earth-repo/iceBox/รูป2/IMG_0160.jpg

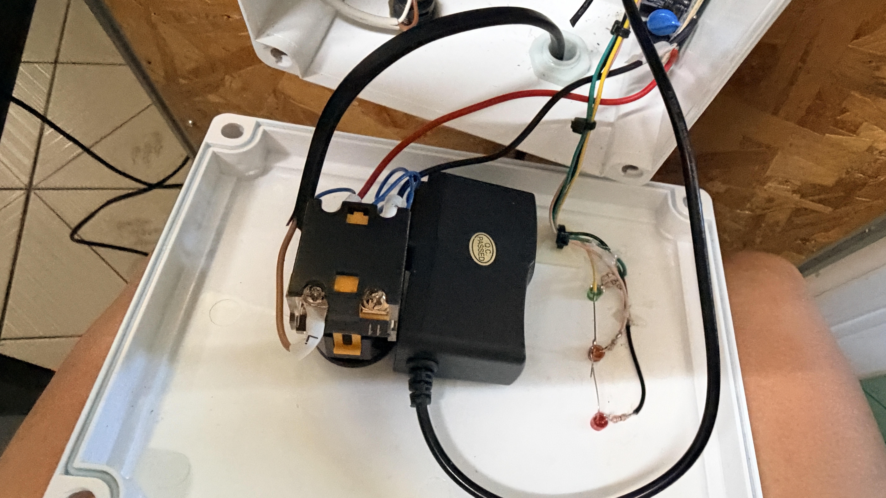
รูป2/IMG_0160.jpg
