earth-repo/iceBox/รูป2/IMG_0157.jpg

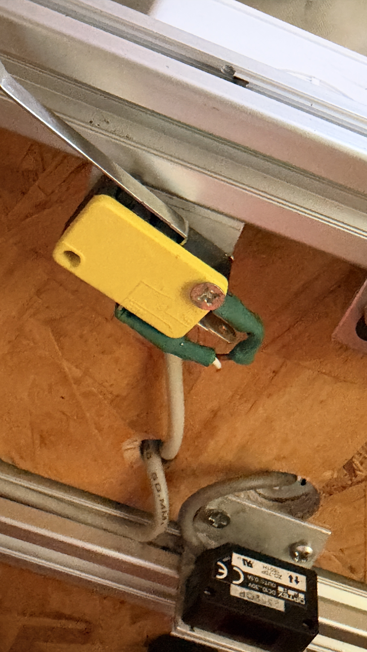
รูป2/IMG_0157.jpg
