earth-repo/iceBox/RESEARCH_REFERENCES.docx

# Research References

Telegram Notification and Internet of Things (IoT)

Peer-reviewed journal articles and conference papers supporting the Smart Parcel Receiving Box project

# 1. Telegram Bot as an IoT Notification Channel

Research papers that use the Telegram Bot API as the mobile alerting channel for an IoT system — the same architecture adopted in this project.

[1] M. N. Osman, M. H. F. Ismail, K. A. Sedek, N. A. Othman, and M. Maghribi, “A Low-Cost Home Security Notification System Using IoT and Telegram Bot: A Design and Implementation,” Journal of Computing Research and Innovation (JCRINN), vol. 7, no. 2, pp. 327–337, 2022. DOI: 10.24191/jcrinn.v7i2.325

https://doi.org/10.24191/jcrinn.v7i2.325

https://jcrinn.com/index.php/jcrinn/article/view/325

Motion sensors and a camera send alert messages containing photo, timestamp and location through a Telegram bot to the homeowner. Reports that the system was efficient, effective, low-cost and easy to use, with positive user-acceptance testing. Use as the principal citation that Telegram bots are an established, validated low-cost notification channel for IoT security applications.

[2] M. I. M. Abu Zaid, R. Abdullah, S. I. Ismail, and N. N. S. N. Dzulkefli, “IoT-based Emergency Alert System Integrated with Telegram Bot,” in Proc. 2023 IEEE International Conference on Automatic Control and Intelligent Systems (I2CACIS), 2023, pp. 126–131. DOI: 10.1109/I2CACIS57635.2023.10193550

https://doi.org/10.1109/i2cacis57635.2023.10193550

https://ieeexplore.ieee.org/document/10193550/

IEEE-indexed conference paper integrating a Telegram bot to extend the notification capability of an IoT alert system. The strongest IEEE citation available specifically for the Telegram-as-alert-channel design decision.

[3] D. N. Bestari and A. Wibowo, “An IoT Based Real-Time Weather Monitoring System Using Telegram Bot and Thingsboard Platform,” International Journal of Interactive Mobile Technologies (iJIM), vol. 17, no. 6, pp. 4–19, 2023. DOI: 10.3991/ijim.v17i06.34129

https://doi.org/10.3991/ijim.v17i06.34129

https://online-journals.org/index.php/i-jim/article/view/34129

Highly relevant to the notification-throttling design: reports Telegram notifications delivered within 3–5 seconds of a critical condition, while normal-condition messages are delayed by 10 minutes explicitly to avoid message spamming. This is the peer-reviewed justification for the cooldown timer (TELEGRAM_COOLDOWN_MS) and the sustained-trigger delay (MAX_SENSOR_DELAY_MS) used in this project. It also pairs a bot with a dashboard platform, mirroring the Telegram + Firebase dashboard split here.

[4] EJASET, “Development of an Internet-of-Things (IoT) Based Security System Using ESP32 MCU and the Telegram Bot,” European Journal of Applied Science, Engineering and Technology.

https://ejaset.com/index.php/journal/article/view/524

Closest match to this project's exact hardware/software stack — ESP32 microcontroller as the sensing node with the Telegram Bot as the notification medium. Primary related-work citation for the controller-plus-Telegram combination.

[5] Y. Yulianto et al., “Rancang Bangun Smart Home berbasis IoT Menggunakan Telegram Messenger Bot dan NodeMCU ESP32,” TELKA — Telekomunikasi, Elektronika, Komputasi dan Kontrol, vol. 9, no. 1, pp. 34–43, 2023.

https://telka.ee.uinsgd.ac.id/index.php/TELKA/article/view/telka.v9n1.34-43

Peer-reviewed smart-home implementation pairing a Telegram Messenger bot with an ESP32 for both monitoring and two-way control. Useful for arguing the future-work extension from one-way notification to bidirectional command (e.g. remotely resetting the parcel count).

[6] P. Kumar et al., “Development of an IoT-based Intelligent Energy Management System with Motion Notification on Telegram in a Smart Home,” in Proc. 5th International Conference on Information Management & Machine Intelligence (ICIMMI), ACM, 2023. DOI: 10.1145/3647444.3647921

https://dl.acm.org/doi/10.1145/3647444.3647921

ACM-indexed paper using a Telegram chatbot for real-time status notification so that the occupant stays informed while away from the premises — exactly the use case of the parcel box (owner is away when the parcel arrives).

# 2. Foundational IoT Research (Architecture & Technologies)

Highly cited survey papers used to define IoT and to frame the system-architecture chapter of the report.

[7] L. Atzori, A. Iera, and G. Morabito, “The Internet of Things: A survey,” Computer Networks, vol. 54, no. 15, pp. 2787–2805, Oct. 2010. DOI: 10.1016/j.comnet.2010.05.010

https://doi.org/10.1016/j.comnet.2010.05.010

https://www.cs.mun.ca/courses/cs6910/IoT-Survey-Atzori-2010.pdf

The seminal IoT survey (14,000+ citations). Establishes the three visions of IoT — things-oriented, internet-oriented and semantic-oriented — and the enabling technologies. The standard opening citation for any IoT literature review.

[8] A. Al-Fuqaha, M. Guizani, M. Mohammadi, M. Aledhari, and M. Ayyash, “Internet of Things: A Survey on Enabling Technologies, Protocols, and Applications,” IEEE Communications Surveys & Tutorials, vol. 17, no. 4, pp. 2347–2376, 2015. DOI: 10.1109/COMST.2015.2444095

https://doi.org/10.1109/COMST.2015.2444095

https://ieeexplore.ieee.org/document/7123563/

The most cited IEEE IoT survey. Defines the layered IoT model — the objects/perception layer (physical sensors that collect and process information), network, service and application layers — and compares application-layer protocols (HTTP, MQTT, CoAP, AMQP). Cite this to position the photoelectric sensor and ESP32 as the perception layer and to justify the choice of HTTP/REST as the application-layer protocol.

# 3. Research on Smart Parcel Boxes and Delivery Lockers

Directly comparable systems — the related-work core of the report.

[9] S. Panyoyai et al., “Development of A Smart Box Prototype for Mail and Parcel Posts Using IoT and Solar Energy,” in Proc. 2022 5th International Conference on Information and Communications Technology (ICOIACT), Yogyakarta, Indonesia, 2022, pp. 77–81. DOI: 10.1109/ICOIACT55506.2022.9972195

https://doi.org/10.1109/ICOIACT55506.2022.9972195

https://ieeexplore.ieee.org/document/9972195/

The closest IEEE-indexed precedent to this project. A smart box receives postal parcels and pushes an arrival notification to the recipient's phone (via LINE Notify), achieving an average performance of 96% across various envelope and parcel types. Use as the quantitative comparison baseline and to justify choosing Telegram over LINE Notify.

[10] M. R. Firdaus et al., “IoT-Based Package Drop Box System Using Arduino Uno and ESP32-CAM,” Jurnal Sistem Cerdas.

https://apic.id/jurnal/index.php/jsc/article/view/581

ESP32 + Telegram package drop box detecting parcel arrival with an ultrasonic sensor at ~10 cm, plus an ESP32-CAM for security. The key comparison point for the detection method: ultrasonic ranging versus the photoelectric beam-break counting used in this project — supports the argument that beam-break gives a discrete count per parcel, which ranging cannot.

[11] A. Rahman et al., “IoT-Based Smart Locker: Innovation in Automatic Package Reception,” TELKA — Telekomunikasi, Elektronika, Komputasi dan Kontrol, vol. 12, no. 1, pp. 17–22.

https://telka.ee.uinsgd.ac.id/TELKA/article/download/telka.v12n1.17-22/telka.v12n1.17-22_pdf/3075

Peer-reviewed automatic package-reception locker. Useful for comparing the mechanical reception workflow — particularly the separate deposit and retrieval access model, which matches the Input (top) / Output (front-bottom) door arrangement of this box.

[12] Design and implementation of an IoT-based automatic package box security system with vibration sensors and GSM notifications using ESP32, “Jurnal Sains, Teknologi & Komputer,”

https://jurnal.larisma.or.id/index.php/SAINTEK/article/view/1630

ESP32 parcel box with vibration-based anti-theft detection and GSM call notification. Comparison point for notification transport — GSM/SMS (recurring SIM cost, works without Wi-Fi) versus Wi-Fi/Internet messaging (zero marginal cost, requires coverage) — and a reference for anti-theft future work.

[13] T. Alsboui et al., “Design and Implementation of an IoT-Integrated Smart Locker System utilizing Facial Recognition Technology,” Engineering, Technology & Applied Science Research (ETASR), vol. 14, no. 4, Aug. 2024.

https://etasr.com/index.php/ETASR/article/view/7737

Recent Scopus-indexed smart-locker research using ESP32 and Firebase with a dual-door design granting independent access to the courier and the owner. Directly supports both the two-door architecture and the Firebase backend choice, and points to authentication as future work.

[14] A Review Paper on Secure Smart Parcel Receiving System, “International Journal of Progressive Research in Engineering Management and Science (IJPREMS),”

https://www.ijprems.com/ijprems-paper/a-review-paper-on-secure-smart-parcel-receiving-system

Review article surveying secure smart parcel receiving systems. Useful for the problem-statement section — growth of e-commerce, parcel theft, and failed deliveries when the recipient is absent.

# 4. Research on Telegram Platform Security and Reliability

Papers supporting the security-analysis and limitations chapter.

[15] M. Miculan and N. Vitacolonna, “Automated Symbolic Verification of Telegram's MTProto 2.0,” arXiv:2012.03141, 2020.

https://arxiv.org/abs/2012.03141

Formal symbolic verification of MTProto 2.0, the cryptographic protocol suite underlying Telegram. Provides an academically rigorous statement of the security properties (and their boundaries) of the messaging platform the notification layer depends on.

[16] A. Edu, X. Ferrer-Aran, J. Such, and G. Suarez-Tangil, “Exploring the Security and Privacy Risks of Chatbots in Messaging Services,” in Proc. ACM Internet Measurement Conference (IMC), 2022.

https://strathprints.strath.ac.uk/85489/1/Edu_etal_ACM_IMC_2022_Exploring_the_security_and_privacy_risks_of_chatbots.pdf

ACM IMC measurement study of chatbot security and privacy risks across Discord, Telegram and WhatsApp, showing how bots can expose users' sensitive data. Cite as the balanced counter-argument in the limitations section: convenience and zero cost of a Telegram bot come with a third-party-platform trust assumption.

[17] A Large-Scale Study of Telegram Bots, “arXiv preprint,”

https://arxiv.org/abs/2603.24302

Large-scale empirical measurement of the Telegram bot ecosystem (32,000+ bots), documenting both its breadth of legitimate services and its abuse. Provides scale evidence when arguing that the Bot API is a mature, widely adopted platform.

# Mapping: Project Topic → Research Reference

Project topic | References
Telegram bot as an IoT notification channel | [1], [2], [4], [5], [6]
Notification delay / anti-spam throttling design | [3]
Telegram + dashboard platform combination | [3], [13]
Two-way control via Telegram (future work) | [5]
Definition and scope of IoT | [7], [8]
IoT layered architecture (perception → application) | [8]
Choice of HTTP/REST as application protocol | [8]
Smart parcel box — direct precedent & baseline | [9]
Parcel detection method comparison | [10]
Separate deposit / retrieval door design | [11], [13]
Notification transport comparison (Wi-Fi vs GSM) | [12]
Firebase backend for a parcel locker | [13]
Problem statement (e-commerce, parcel theft) | [14]
Security analysis and limitations | [15], [16], [17]

Summary: 17 academic sources — IEEE conference papers [2], [8], [9]; indexed journal articles [1], [3], [5], [11], [13]; an ACM conference paper [6] and an ACM IMC measurement study [16]; the two foundational IoT surveys [7], [8]; and peer-reviewed regional journal work [4], [10], [12], [14]. Vendor datasheets and official API documentation are deliberately excluded from this list; they are available separately in REFERENCES.docx as technical documentation.

All sources verified accessible as of 7 September 2026.
