earth-repo/iceBox/รูป2/IMG_0155.jpg

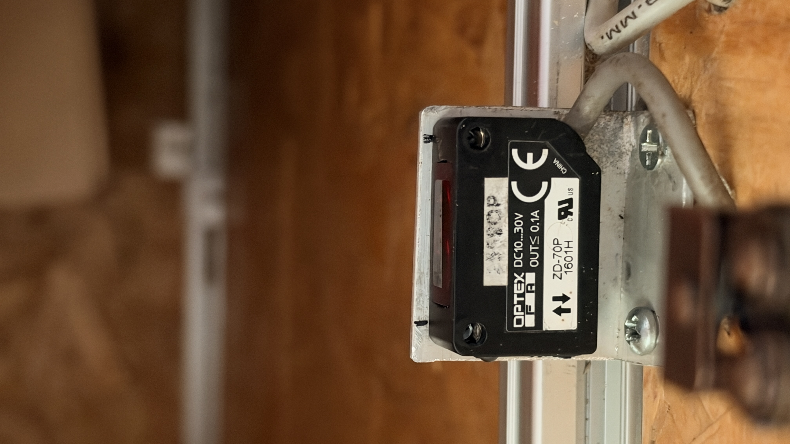
รูป2/IMG_0155.jpg
