earth-repo/iceBox/รูป2/IMG_0156.jpg

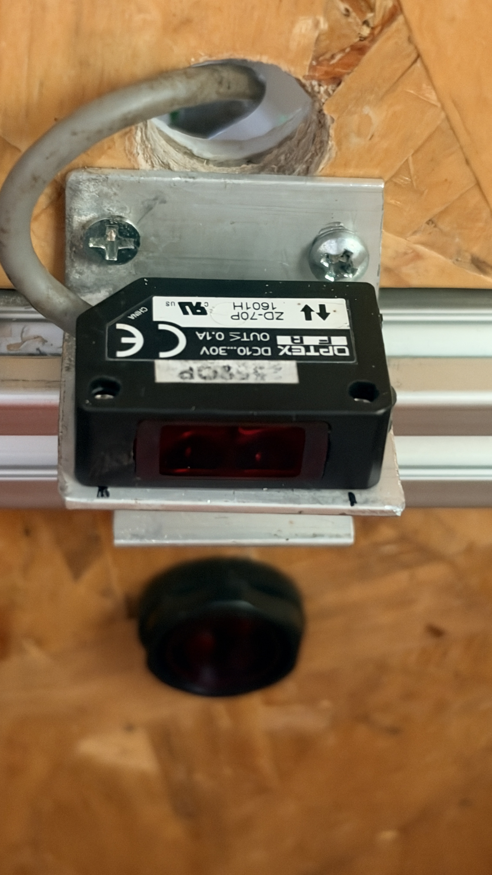
รูป2/IMG_0156.jpg
