earth-repo/iceBox/รูป2/IMG_0158.jpg

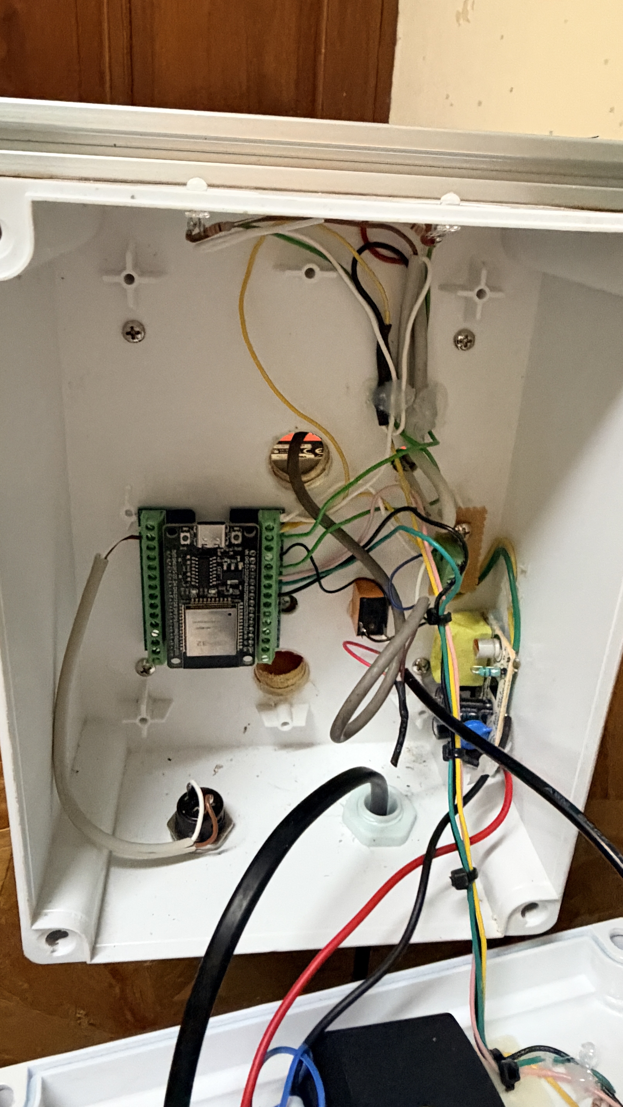
รูป2/IMG_0158.jpg
