earth-repo/iceBox/รูป2/IMG_0159.jpg

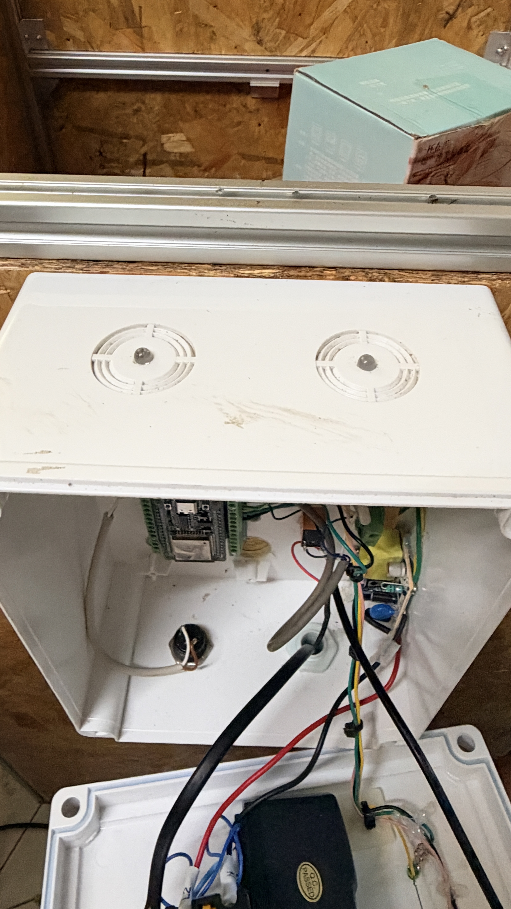
รูป2/IMG_0159.jpg
