earth-repo/iceBox/รูป2/IMG_0161.jpg

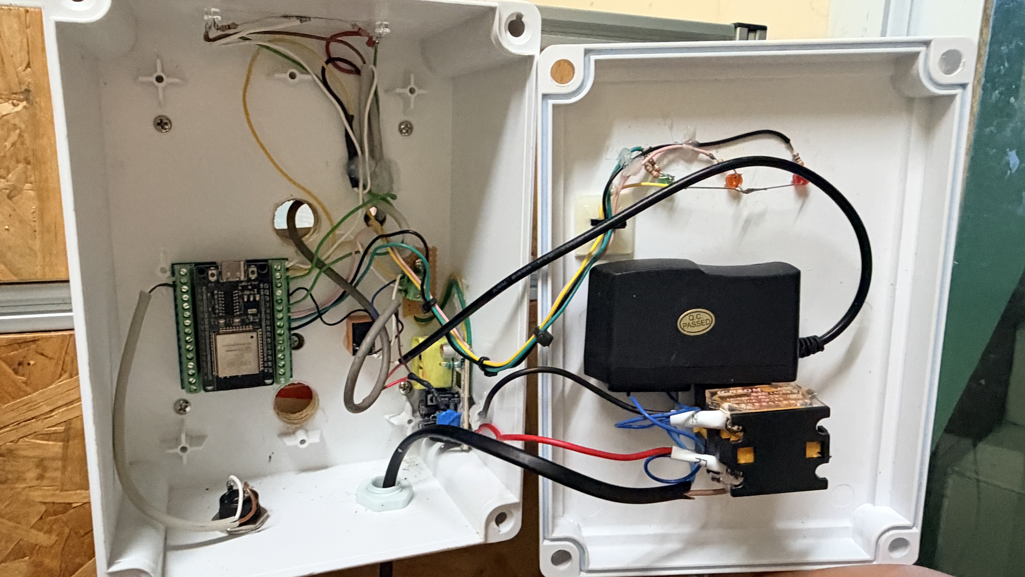
รูป2/IMG_0161.jpg
