earth-repo/iceBox/รูป2/IMG_0162.jpg

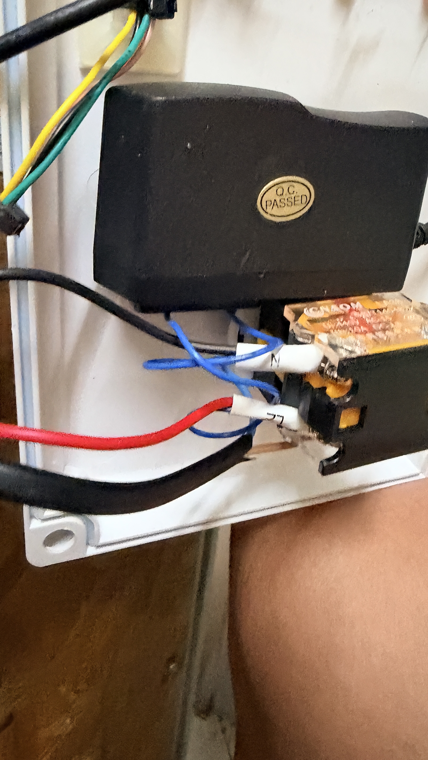
รูป2/IMG_0162.jpg
