earth-repo/iceBox/รูป2/IMG_0163.jpg

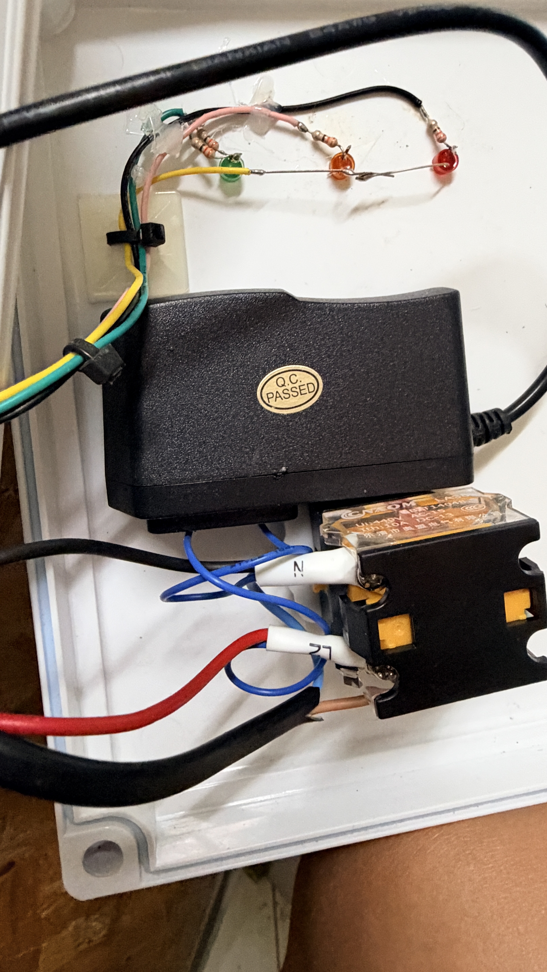
รูป2/IMG_0163.jpg
