earth-repo/iceBox/รูป2/IMG_0164.jpg

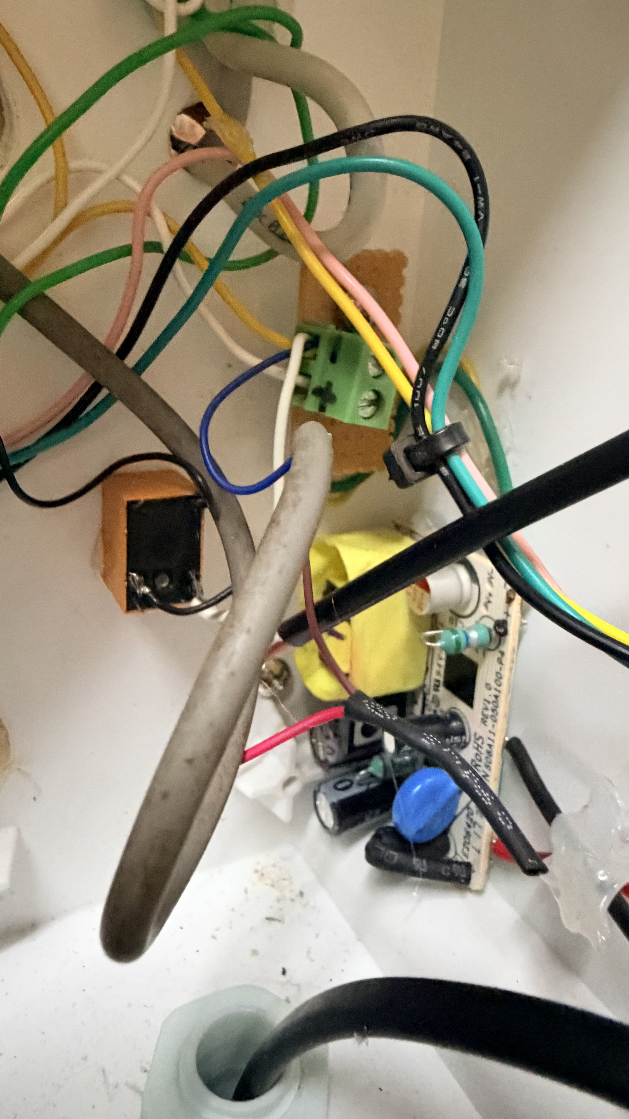
รูป2/IMG_0164.jpg
