earth-repo/iceBox/(commit log)

2026-03-08 feat: Implement analog sensor reading and update serial communication settings.
2026-03-08 feat: add a statistics dashboard to the UI with Firebase data integration and filtering capabilities.
2026-10-01 feat: Add ESP32 Firebase/Telegram link kit with on-device setup portal
    Add a handoff kit in firebase_link_example/: firebase_link.h (status,
    events, daily stats), telegram_link.h (notifications), wifi_setup.h
    (WiFiManager portal for WiFi + Telegram settings stored in flash) and
    an example sketch. firebase_link.txt documents what is sent and
    received and embeds the code. Ignore *.zip so handoff archives that
    contain config.h are not committed.
2026-10-03 เพิ่ม iceBox — โปรแกรมหลักที่รวมทุกอย่างไว้ในโฟลเดอร์เดียว
    - iceBox/: รวม program_v2 (LED หน้าตู้, จำจำนวนพัสดุหลังไฟดับ) กับชุด
    firebase_link (หน้าตั้งค่า WiFi/Telegram, นับพัสดุด้วย interrupt)
    - iceBox/wifi_setup.h: ค่า WiFi/Telegram จาก config.h ถูกใช้เมื่อ upload
    ครั้งแรกหรือแก้ config.h แล้ว upload ใหม่ ส่วนค่าที่ตั้งจากหน้าตั้งค่า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
2026-10-03 ปรับการนับพัสดุและแจ้งตู้เต็มของ iceBox ให้แม่นขึ้น และส่งแจ้งเตือนเร็วขึ้น
    การนับและตู้เต็ม (iceBox.ino, config.h.example)
    - ใช้ photo sensor ตัวเดียวที่ขา 14 ทั้งนับพัสดุและตรวจตู้เต็ม ตัด PIN_MAX_SS ออก
    และย้ายขา limit switch ของประตู: บังแล้วปล่อย = พัสดุ 1 ชิ้น,
    บังค้างครบ FULL_DELAY_MS (10 วินาที) = ตู้เต็ม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
2026-10-04 แสดงสถานะ WiFi ของ ESP32 (ออนไลน์/ออฟไลน์) บน dashboard
    แถบเชื่อมต่อเดิมบอกแค่ว่าหน้าเว็บต่อ Firebase ได้ ไม่ได้บอกว่า ESP32
    ยังส่งข้อมูลอยู่หรือไม่ จึงเพิ่มบรรทัดสถานะ ESP32 ใต้แถบเดิม
    - ดูจาก lastUpdate ที่ ESP32 เขียนทุกครั้งที่ส่งสถานะ (ทุก ~3 วินาที)
    ถ้าเก่าเกิน 20 วินาทีถือว่าออฟไลน์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
2026-10-04 สั่ง deploy GitHub Pages ใหม่
    รอบ deploy ของ commit ก่อนหน้า build ผ่านแต่ขั้น "Deploy to GitHub Pages"
    ล้มเหลวฝั่ง GitHub — commit เปล่านี้ไว้กระตุ้นให้ deploy อีกรอบ ไม่มีการแก้ไฟล์
2026-10-04 ปรับข้อความแถบเชื่อมต่อบน dashboard ให้บอกว่าอะไรเชื่อมต่อกับอะไร
    ข้อความเดิม "เชื่อมต่อแล้ว — Real-time (อัปเดตทันที)" ไม่ได้บอกว่าอะไรเชื่อมต่อ
    อ่านแล้วเข้าใจผิดได้ว่าหมายถึง ESP32 ทั้งที่หมายถึงหน้าเว็บต่อ Firebase
    - ข้อความแถบบนทุกสถานะขึ้นต้นด้วย "หน้าเว็บ:" และระ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
2026-10-04 เพิ่มปุ่มลบสถิติพัสดุบน dashboard พร้อมขั้นยืนยันก่อนลบ
    เดิมลบสถิติจากหน้าเว็บไม่ได้ ต้องเข้าไปลบใน Firebase Console เอง
    - ปุ่ม "ลบสถิติ" ในการ์ดสถิติพัสดุ กดแล้วยังไม่ลบ แต่ขึ้นกล่องยืนยัน
    บอกจำนวนวัน ช่วงวันที่ และจำนวนพัสดุที่จะถูกลบ ต้องกด "ยืนยันลบ" อีกครั้ง
    -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
2026-10-04 เอาอีเมลและรหัสผ่านที่กรอกไว้ล่วงหน้าออกจากหน้าล็อกอิน
    ช่องอีเมลและรหัสผ่านใน index.html เคยใส่ value ไว้เพื่อให้ทดสอบง่าย
    ทำให้ใครเปิดหน้าเว็บก็กดเข้าสู่ระบบได้ทันที ตอนนี้ช่องว่าง ต้องพิมพ์เอง
    แก้เฉพาะหน้าเว็บ ไม่ได้เปลี่ยนรหัสผ่านใน Firebase
    ค่าเดิมยังอ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
2026-10-04 ให้ไฟแดงกะพริบเมื่อเปิดประตูรับพัสดุเข้า เหมือนตอนเปิดประตูนำพัสดุออก
    เดิมเปิดประตูรับพัสดุเข้า (ฝาบน) แล้วไฟแดงหน้าตู้ติดค้าง แยกไม่ออกจากสถานะตู้เต็ม
    ตอนนี้ไฟแดงกะพริบระหว่างที่ประตูเปิด ส่วนไฟเขียวและเหลืองยังแสดงตามจำนวนพัสดุ
    - iceBox.ino: updateLEDs()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
2026-10-04 เพิ่มเอกสารอธิบายการทำงาน flowchart แผนผังวงจร และวงจรไฟฟ้า และปรับเอกสารเดิมให้ตรงกับตู้จริง
    เอกสารใหม่ (สำหรับเสนออาจารย์ที่ปรึกษา ระดับ ปวช.)
    - อธิบายการทำงาน_กล่องรับพัสดุอัจฉริยะ.docx: อธิบายระบบ เซนเซอร์ ไฟ LED
    การต่อวงจร ขั้นตอนโปรแกรม การแจ้งเตือน Telegram แ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
2026-10-04 เพิ่มรูปถ่ายการต่อวงจรจริงของตู้ (โฟลเดอร์ รูป2)
    รูปถ่าย 10 รูปของตู้จริง ใช้อ้างอิงเทียบกับโปรแกรม iceBox.ino และเอกสาร
    - Photo sensor OPTEX ZD-70P และ Limit switch ที่ติดในตู้
    - กล่องควบคุม: ESP32 บน screw board, Relay, Adaptor 5 V และ 9 V
    - ฝากล่อง: สวิตช์กดค้าง และ LED สถานะ 3 ดวง
